zhongzhiji/xianwai-zhixin/docs/bluetooth.md

# JDY-31、CP2102 与 Tang Mega 138K Pro 接线

适用：本项目 `demo_showcase` 音游蓝牙版。新版 FPGA 默认 9600，适配从未配置的 JDY-31；旧屏幕完善版/联调增强版位流是 115200。模块、FPGA 接收器必须匹配。FPGA 无线入口仍为单向接收，实际连通需要板上验证。

## 没有 CP2102 的直接方案

不需要先改 JDY-31 参数：使用本版 9600 固件，JDY-31 TXD 接 J22.12，GND 共地，VCC 依具体底板额定电压接线。Windows 蓝牙配对成功后选择出站 SPP COM 口，打开网页“连接所选串口”；电脑无需 CP2102。Windows 若没有蓝牙适配器，可用 Android 经典蓝牙 SPP 串口应用直接发送协议字节。普通手机 H5 不能直接控制 JDY-31 SPP。旧 115200 固件不能直接接常见出厂 9600 模块。

下面“CP2102 配置”仅为以后找回转换器、希望改用旧 115200 固件时的可选方案，本次不用执行。

## 先认清三个部件

- JDY-31：Bluetooth 3.0 SPP 从机，把无线收到的数据送到 UART TXD。传输音符和曲谱事件，不是蓝牙音箱或音频解码器。
- CP2102：电脑 USB 转 UART，先用来配置 JDY-31，也可替代蓝牙直接向 FPGA 下发。它本身没有蓝牙无线功能。
- 138K：已有 `bt_rx=M26`，在底板 PMOD0/J22 的第 12 脚。新版 UART 为 9600、8 数据位、无校验、1 停止位，无硬件流控。

本地依据：`demo_showcase/constraints/music_pro.cst` 第 43–46 行，`demo_showcase/rtl/top_music_pro.v` 的 `BT_BAUD=9600` 与 `BT_CLK_PER_BIT=(35000000+BT_BAUD/2)/BT_BAUD`（3646）。接收器运行在 35 MHz 像素时钟域，不能误用模块默认的 50 MHz 参数 434。

## 供电必须按实物版本确认

京东短链分别解析到 JDY-31 商品 10223078233570 和 CP2102 商品 10150843291525，但没有取得能确认所选四针板供电及六合一跳帽含义的电气资料。因此此处不按“四针”猜供电。

JDY-31 手册区分两种版本：裸贴片模块 1.8–3.6 V，推荐 3.3 V；带稳压底板款 3.6–6 V，推荐 5 V。[JDY-31 原模块手册，参数页](https://myosuploads3.banggood.com/products/20190517/20190517042108JDY31V1.3.pdf)

供电电压和 TXD/RXD 的逻辑电平是两个概念。即使 VCC 接 5 V，送入 FPGA 的 UART 信号仍须是 3.3 V 逻辑。六合一 CP2102 必须使用 TTL/UART 接口，不使用 RS232 或 RS485 接口；不要仅凭供电跳帽就认定 TXD 电平已切换。

先对照模块背面 VCC 标注与卖家对应型号说明。若标注不清，补拍 JDY-31 正反面、CP2102 跳帽与排针区，再确定供电线。连接信号前可用万用表核对空闲 TXD 对 GND 约为 3.3 V。所有改线在断电时进行。

## 可选步骤 CP2102 配置为旧版 115200

此时 JDY-31 不接 FPGA，也不连接手机蓝牙。

| CP2102 | JDY-31 |
|---|---|
| TXD，确认 3.3 V TTL | RXD |
| RXD | TXD |
| GND | GND |
| 与模块额定输入匹配的供电输出 | VCC |

电脑插入 CP2102，串口助手选对应 COM。常见出厂设置为 9600、8N1、无流控。使用文本/ASCII 发送，每条命令末尾追加真正的 CR+LF（0D 0A），不是输入四个可见字符 `\r\n`。手册有不同固件版本，以实际回包为准。

1. 发 `AT+VERSION`，记录返回版本；再发 `AT+BAUD` 查询当前速度。
2. 固件支持时发 `AT+ENLOG0` 关闭启动/连接状态文本，避免这些文本混入业务串口。
3. 可选发 `AT+NAMEXianWaiZhiXin`，设置便于拍摄识别的名称。
4. 发 `AT+BAUD8`，对应 115200。收到应答后重启模块，把串口助手改为 115200，再查询 `AT+VERSION`、`AT+BAUD` 确认。部分版本改变波特率的生效时点不同，不以一次无回包判定损坏。

若 9600 无回包，先查供电、TX/RX、COM、换行和蓝牙是否已经连接；再检查是否此前已设成 115200。不要套用 HC-05 的 KEY 按键、38400 波特率或 `AT+UART=` 命令。

[JDY-31 原模块手册：CRLF、BAUD8=115200、ENLOG](https://www.es.co.th/Schemetic/PDF/JDY-31-K1234.PDF)。常见配对 PIN 为 1234，已改过的模块以实际设置为准。

## 第二步：JDY-31 接 138K

使用新版 9600 固件可直接进入这一步，无需 CP2102。若此前用转换器配置过模块，先拆下其 TXD/RXD。

| JDY-31 引脚 | 138K 连接 |
|---|---|
| TXD | PMOD0 / J22 第 12 脚，即 FPGA M26 / `bt_rx` |
| GND | J22 第 3 或第 4 脚，GND |
| VCC | 按模块额定电压选择，见下方 |
| RXD | 本版暂不接；FPGA 尚无 `bt_tx` 回传输出 |

对照已核对的 4071f 底板原理图：J22 第 1、2 脚是 3.3 V，第 3、4 脚是 GND，第 12 脚是 M26。需要 5 V 的底板款不能把 J22 的 3.3 V 当成 5 V；原理图 J23 第 11 脚为 +5 V，但只有确认你们实物底板版本、排针编号和供电需求后才使用该供电点。也可使用匹配的独立模块电源，并与 FPGA 共地。

请按 PCB 的 1 脚标识和原理图数脚，不按网上通用 PMOD 图片猜左右方向。这里的 M26 是 FPGA 封装脚号，并非板上第 26 个排针。不可把模块四针整排插进 J22。

[Sipeed 官方 4071f 底板原理图，第 16 页 EX CONN](https://dl.sipeed.com/fileList/TANG/Mega_138K_Pro/02_Schematic/TANG_MEGA-138K_Pro-Dock-4071f_Schematics.pdf)

## 第三步：先验证音符，再导入曲谱

烧录已有 `music_pro_showcase.fs`，用 S2 跳到屏幕标注的第 26 段 PHONE UART，按 S1 停留。这样后续自动段落不会覆盖手机操作。

安卓手机先配对 JDY-31，再在支持经典蓝牙 SPP 的串口工具里打开连接。配对成功不等于已经打开串口会话。发送方式必须是 HEX/十六进制原始字节，下面内容不要作为 ASCII 字符串发送，也不要追加换行：

```text
90 3C 64
```

这是 C4 的 Note On，力度 100。短暂试听后发送：

```text
80 3C 00
```

这是 C4 的 Note Off。手机 MIDI 接口当前采用最后音符优先，不把多指操作描述为独立多指复音。断开连接前先发送 Note Off；发生持续发声可复位 FPGA，现有协议没有无线断连确认。

三音曲谱测试：C4、D4、E4，每音一拍，120 BPM。一次连续 HEX 发送以下 21 字节：

```text
55 4C 03 78
55 57 00 3C 04
55 57 01 3E 04
55 57 02 40 04
55 43
```

以 FPGA 屏幕和音频变化确认接收。当前 FPGA 没有 ACK 回传，不会给串口工具返回“成功”。手机显示“发送成功”只说明发送动作完成。

JDY-31 是经典 SPP，不是 BLE MIDI。常见 iPhone 应用不能按本方案直接连接 JDY-31；安卓最方便。[模块供应商支持范围说明](https://docs.sunfounder.com/projects/ultimate-sensor-kit/en/latest/components_basic/38-component_jdy31.html)

现有 H5 手机页面通过电脑网关工作，不能直接访问 JDY-31 的经典 SPP。若 Windows 已成功配对模块并建立可用的 SPP 出站 COM，可将这个 COM 交给现有网关，形成“手机 Wi-Fi → 电脑 → 蓝牙 → JDY-31 → FPGA”链路；需实际验证 Windows 与该模块固件的兼容性。

## 先用 CP2102 做有线基线

这是排除无线故障最快的一步：完全移开 JDY-31 的 TXD，CP2102 TXD 接 J22.12，GND 接 J22.3/4。FPGA 按原方式供电，不接 CP2102 的 5 V/3.3 V 输出到开发板电源。CP2102 RXD 暂不接。

电脑按位流版本设 9600（本版）或 115200（旧版）、8N1、无流控，发送同样的 HEX 音符和曲谱；也可启动已有手机网关，填 CP2102 的 COM 口。先确认有线成功，再换 JDY-31。严禁两块模块的 TXD 同时接 M26。

CP2102 的芯片 UART 和供电定义可查 [Silicon Labs 数据手册](https://www.silabs.com/documents/public/data-sheets/CP2102-9.pdf)，但六合一成品板上跳帽与电平转换仍以该产品电路为准。

## 与压力采集链路的区别

本说明的 M26 是手机音符/曲谱入口。原压力采集入口是 `pressure_rx=C24`，对应 J24 第 11 脚，115200、8N1，解析原来的 16 路压力数据帧；任意串口文本或 MIDI 数据不能代替它。

一个 JDY-31 不会采集压力，也不能因为两端都叫蓝牙模块就自动连接。该型号为从机；若想把原压力采集板无线接到 FPGA，还需确认采集板上的蓝牙角色、数据帧和发送逻辑。两个从机不能直接组成主从透传链路。

本次为接线方案核对，尚未远程操作任何串口、修改模块配置或烧录 FPGA。原提交压缩包保持不变。
