zhongzhiji/xianwai-zhixin/fpga/assets/sd/README.md

# SD 曲谱

当前仓库保留曲谱 JSON 源数据。用于 FAT32 卡的 SONG.BIN 及生成记录见本地完整提交包的 12_SD卡曲谱。此目录不声称包含未提供的 BIN 文件。当前演示按键与舞台顺序请以仓库主 README 和 showcase_stages.json 为准。
