zhongzhiji/xianwai-zhixin/THIRD_PARTY_NOTICES.md

# 第三方与原始声明

- pyserial 3.5：BSD 许可证，原文保留于 fpga/phone_app/vendor/LICENSE_pyserial.txt 和相关元数据；官网 https://github.com/pyserial/pyserial 。
- Gowin 工具生成的 PLL/器件相关代码保留文件内原有声明；器件仿真原语由用户本机工具提供，不附商业工具或许可证。
- 曲谱数据与演示片段沿用项目已有材料，其原始出处/注释保留；本仓库没有为这些内容另行授予第三方音乐版权。
- 项目其余文件按原权利人权利处理，公开可读不表示新增整体开源许可。
