zhongzhiji/xianwai-zhixin/fpga/phone_app/联调增强版说明.md

# 前一版联调说明

本文件原属 115200 联调版本。当前使用方法、9600 源码和测试范围见 [README.md](README.md)。当前源码对应的新位流尚待布局布线完成。
