zhongzhiji/xianwai-zhixin/verification/README.md

# 原始验证记录

2026-11-03 本机实跑记录。路径中的个人工作目录替换为 [workspace]，结果未修改。RTL 31 项含 SD 每簇 8 扇区附加运行；网关 19 项、音游算法 7 项、浏览器 9 项。物理硬件未由这些自动化操作或验证。
