zhongzhiji/xianwai-zhixin/fpga/rtl/top_music_pro.v

`timescale 1ns/1ps
// ============================================================================
//  top_music_pro.v  ——  Tang Mega 138K Pro (GW5AST-LV138FPG676AC1/I0)
//                       音乐工作站 · 完整单工程顶层
//
//  在原 16 复音工程（top_score_fsr16_ui）基础上整合五项拓展：
//    E1  32 复音独立声部引擎        audio/src/fsr32_engine.v
//    E2  硬件效果器机架（旁/回/合/混）audio/src/fx_rack.v
//    B1  蓝牙串口链路（MIDI 子集）    rtl/bt_uart_link.v
//    B2  曲谱在线导入（走蓝牙/USB）   rtl/score_loader_uart.v
//    B3  音游节奏判定 shot 分        rtl/rhythm_judge.v
//
//  设计原则：
//   1. 原压力板链路（fsr16_uart_engine）完整保留 —— 它同时是压力解析与 UI 数据源，
//      也是 ENGINE_PRO=0 时的回退音频链路，便于现场 A/B 对比。
//   2. 全工程只有一对 clk_gen + i2s_tx（本顶层实例化），所有音频链路共用同一帧使能，
//      避免两个 I2S 发射器抢同一组 HP 引脚。
//   3. 音频选择在 48kHz 域做，不在 I2S 位时钟域做，杜绝切换毛刺。
//
//  接口备注：
//    bt_rx  M26  —— 蓝牙模块 TXD（默认 9600 8N1），必须是 3.3V 电平！
//                   上电前用万用表确认 TXD 空载电压 <= 3.3V，否则加装电平转换。
//    pressure_rx C24 —— 原有压力板 UART，不动。
// ============================================================================
module top_music_pro #(
    parameter DEBOUNCE_CYCLES            = 350000,
    parameter HOLD_CYCLES                = 21000000,
    parameter integer BT_BAUD            = 9600, // 新 JDY-31 出厂值；旧模块可设 115200
    parameter DISPLAY_PRESSURE_SHIFT     = 0,
    parameter DISPLAY_PRESSURE_FULL_SCALE= 2048,

    // ============ 常用开关：只改这几行就能换配置，不必动其它文件 ============
    parameter ENGINE_PRO   = 1,           // 1=32复音+效果器（推荐） 0=原16复音链路
    parameter [1:0] FX_MODE = 2'b00,      // 00旁路 01回声 10合唱 11混响
    parameter [3:0] VIB_DEPTH = 4'd0,     // 颤音深度，0=关；建议 8~15
    parameter       GLIDE_EN  = 0,        // 滑音开关（需上层给出 glide_rate）
    parameter       TEST_MODE = 0,        // 1=上电默认打开 N 音测试（三键长按可现场循环）
    parameter [5:0] TEST_COUNT = 6'd32,   // 上电默认测试声部数；运行时档位固定为 4/8/16/32
    // 预录 VOCAL.WAV 不属于赛题的 HDL 实时合成主链，默认不例化。
    // 代码与工具保留供附加演示；ENABLE_VOCAL=1 时需重新评估 BSRAM 与布线。
    parameter       ENABLE_VOCAL = 0,

    parameter ROM_FILE      = "audio/rom/wavetable_showcase.mem",
    parameter SINE_ROM_FILE = "audio/rom/sine_lfo_256.mem",
    parameter MIDI_FW_ROM   = "audio/rom/midi_fw.mem",
    // 弯音轮（Pitch Bend）倍率表：128 项 × 16 bit，Q15 定点（0x8000 = 1.0 倍）
    //   BEND_EN=0 → 旁路（fw 原样通过，省一个乘法器）
    //   表由 tools/gen_bend_lut.py 生成，默认 ±2 半音（MIDI 规范默认音域）
    parameter       BEND_EN  = 1,
    parameter BEND_LUT_FILE  = "audio/rom/bend_lut.mem"
)(
    input  wire       sys_clk,            // P16  50 MHz
    input  wire       rst_n,              // K16
    input  wire       key_play_n,         // F15
    input  wire       key_timbre_n,       // G15
    input  wire       key_demo_n,         // G16

    input  wire       pressure_rx,        // C24  压力板 UART
    input  wire       bt_rx,              // M26  蓝牙模块 TXD

    // 钢琴键盘 —— 方案 A：MIDI 1.0（5 针 DIN 经 6N138 光耦，只占 1 根 IO）
    input  wire       midi_rx,            // P23  40P 排针 J23 物理 9 脚

    // 钢琴键盘 —— 方案 B：8×8 行列矩阵直连电子琴键盘总成（可选，占 16 根 IO）
    //   不用矩阵时这些脚全部悬空即可：列有上拉，行推挽输出不影响其它功能。
    output wire [7:0] kb_row,             // 行驱动（推挽，同一时刻只拉低一根）
    input  wire [7:0] kb_col,             // 列采样（内部上拉，按下被拉低）

    // 触摸载板 TouchCarrier R11（双 MPR121，见 docs/01_触摸载板接线与使用指南.md）
    inout  wire       touch_scl,          // H14  J24.5
    inout  wire       touch_sda,          // H15  J24.6
    input  wire       touch_irq_n,        // L17  J24.7（两颗 IRQ 开漏线或）

    // SD 卡（SPI）—— PMOD2 / J26 的 9..12 脚
    output wire       sd_sclk,            // D23  底板板载 microSD 卡槽
    output wire       sd_mosi,            // D24
    input  wire       sd_miso,            // H23
    output wire       sd_csn,             // B25

    output wire       lcd_clk,
    output wire       lcd_de,
    output wire [5:0] lcd_r, lcd_g, lcd_b,

    output wire [1:0] led_n,
    output wire       hp_bck, hp_ws, hp_din, pa_en
);

    // ------------------------------------------------------------------
    // 1. 时钟与复位
    // ------------------------------------------------------------------
    wire pixel_clk, locked, pixel_reset_n, system_reset_n;
    lcd_pll u_pll(.clkin(sys_clk), .clkout0(pixel_clk), .locked(locked));
    reset_sync u_pixel_reset (.clk(pixel_clk), .reset_button_n(rst_n & locked),
                              .reset_n(pixel_reset_n));
    reset_sync u_system_reset(.clk(sys_clk),  .reset_button_n(rst_n & locked),
                              .reset_n(system_reset_n));

    // ------------------------------------------------------------------
    // 2. 48 kHz 音频时基：全工程唯一一对 clk_gen / i2s_tx
    // ------------------------------------------------------------------
    wire bck, bck_rise, bck_fall, frame_en;
    clk_gen #(.ACC_MOD(50000), .ACC_STEP(3072)) u_ckg(
        .clk(sys_clk), .rst_n(system_reset_n),
        .bck(bck), .bck_rise(bck_rise), .bck_fall(bck_fall));

    // ------------------------------------------------------------------
    // 3. 按键与 UI 控制
    // ------------------------------------------------------------------

    // Offline test stimuli. No pressure/BT device is reported online by these signals.
    wire [4:0] show_stage; wire show_hold;
    wire [15:0] show_gate; wire [6:0] show_expr;
    wire [1:0] show_family,show_preset,show_fx;
    wire [2:0] show_page,show_test;
    wire [3:0] show_vib; wire show_glide,show_melody,show_backing;
    wire [31:0] show_word;
    wire show_pause_press,show_next_press,show_restart_press;
    ui_action_button #(.DEBOUNCE_CYCLES(500000),.HOLD_CYCLES(30000000)) u_show_s1(
        .clk(sys_clk),.reset_n(system_reset_n),.button_n(key_play_n),
        .short_press(show_pause_press),.long_press(),.pressed());
    ui_action_button #(.DEBOUNCE_CYCLES(500000),.HOLD_CYCLES(30000000)) u_show_s2(
        .clk(sys_clk),.reset_n(system_reset_n),.button_n(key_timbre_n),
        .short_press(show_next_press),.long_press(show_restart_press),.pressed());
    showcase_director u_show(.clk(sys_clk),.reset_n(system_reset_n),
        .pause_press(show_pause_press),.next_press(show_next_press),.restart_press(show_restart_press),
        .stage(show_stage),.held(show_hold),.gate(show_gate),.expression(show_expr),
        .family(show_family),.preset(show_preset),.fx(show_fx),.page(show_page),
        .test_sel(show_test),.vib_depth(show_vib),.glide(show_glide),
        .melody(show_melody),.backing(show_backing),.freq_word(show_word));
    wire [21:0] show_config_pixel;
    bus_snapshot_cdc #(.WIDTH(22)) u_show_mailbox(
        .src_clk(sys_clk),.src_reset_n(system_reset_n),
        .src_data({show_hold,show_stage,show_page,show_family,show_preset,show_fx,show_test,show_backing,3'b000}),
        .dst_clk(pixel_clk),.dst_reset_n(pixel_reset_n),.dst_data(show_config_pixel));
    wire [4:0] show_stage_p=show_config_pixel[20:16];
    wire show_serial,show_serial_busy,show_serial_done;
    reg [4:0] show_stage_prev;
    always @(posedge pixel_clk or negedge pixel_reset_n)
        if(!pixel_reset_n) show_stage_prev<=31; else show_stage_prev<=show_stage_p;
    showcase_uart_rom #(.CLK_PER_BIT((35000000+BT_BAUD/2)/BT_BAUD)) u_show_serial(
        .clk(pixel_clk),.reset_n(pixel_reset_n),
        .start(show_stage_p==23 && show_stage_prev!=23),
        .tx(show_serial),.busy(show_serial_busy),.done(show_serial_done));
    wire selected_bt_rx=show_serial_busy ? show_serial : bt_rx;

    wire short_play, long_song, short_timbre, long_family, short_page, long_mode;
    wire [2:0] button_pressed, button_short, button_long, normal_short, normal_long;
    wire volume_edit;
    wire [4:0] volume_step;
    wire [1:0] practice_mode;
    wire backing_enabled;
    assign {short_page, short_timbre, short_play} = normal_short;
    assign {long_mode,  long_family,  long_song } = normal_long;

    ui_action_button #(.DEBOUNCE_CYCLES(DEBOUNCE_CYCLES), .HOLD_CYCLES(HOLD_CYCLES)) u_s1(
        .clk(pixel_clk), .reset_n(pixel_reset_n), .button_n(1'b1),
        .short_press(button_short[0]), .long_press(button_long[0]),
        .pressed(button_pressed[0]));
    ui_action_button #(.DEBOUNCE_CYCLES(DEBOUNCE_CYCLES), .HOLD_CYCLES(HOLD_CYCLES)) u_s2(
        .clk(pixel_clk), .reset_n(pixel_reset_n), .button_n(1'b1),
        .short_press(button_short[1]), .long_press(button_long[1]),
        .pressed(button_pressed[1]));
    ui_action_button #(.DEBOUNCE_CYCLES(DEBOUNCE_CYCLES), .HOLD_CYCLES(HOLD_CYCLES)) u_s3(
        .clk(pixel_clk), .reset_n(pixel_reset_n), .button_n(key_demo_n),
        .short_press(button_short[2]), .long_press(button_long[2]),
        .pressed(button_pressed[2]));
    wire fx_step, test_step;   // 三键齐按：短按换效果器 / 长按换 N 音测试
    ui_volume_control #(.HOLD_CYCLES(HOLD_CYCLES)) u_volume_controls(
        .clk(pixel_clk), .reset_n(pixel_reset_n), .pressed(button_pressed),
        .short_action(button_short), .long_action(button_long),
        .normal_short(normal_short), .normal_long(normal_long),
        .volume_edit(volume_edit), .volume_step(volume_step),
        .practice_mode(practice_mode), .backing_enabled(backing_enabled),
        .fx_step(fx_step), .test_step(test_step));

    // ------------------------------------------------------------------
    // 4. 压力显示映射
    // ------------------------------------------------------------------
    wire [7:0]  frame_count;
    wire [43:0] controls_pixel, controls_system;
    wire [15:0] live_gate;
    wire        frame_ok, online;
    wire [23:0] dev_max;
    wire [6:0]  expression;
    wire [23:0] display_deviation = dev_max >> DISPLAY_PRESSURE_SHIFT;
    // ------------------------------------------------------------------
    // 4c. 演奏力度（表情）通路的下限保护
    //
    //    【为什么必须加这一层】
    //    expression 来自 pressure_display_mapper，而那个模块的注释自己就写着
    //    "Display-only pressure normalization" —— 它是**给显示用的**归一化值：
    //      !online   → level = 0      （压力板没连）
    //      deviation==0 → level = 0  （没用力按）
    //    但 fsr32_engine 把 expression 当成主增益（gain = expression/128），
    //    直接接等于：不接压力板、或轻轻按一下，整条 32 复音链路就几乎静音。
    //    这就是"接音响声音很小"的第一个原因。
    //
    //    所以给表情通路兜底：离线用默认力度，在线但有力度时限制下限。
    //    设下限不会产生底噪 —— expression 只是增益，gate=0 时声部输出本来就是 0。
    // ------------------------------------------------------------------
    parameter [6:0] EXPR_DEFAULT = 7'd112;   // 压力板离线时的默认力度（满量程 127）
    parameter [6:0] EXPR_MIN     = 7'd56;    // 在线时的力度下限，避免轻触近乎无声

    wire [6:0] expr_eff = !online              ? EXPR_DEFAULT :
                          (expression < EXPR_MIN) ? EXPR_MIN     : expression;

    // 沿用原语义：expression 仍按真实值送去做显示
    pressure_display_mapper #(.FULL_SCALE(DISPLAY_PRESSURE_FULL_SCALE)) u_pressure_display(
        .clk(sys_clk), .reset_n(system_reset_n), .online(online),
        .deviation(display_deviation), .level(expression));

    wire enabled   = 1'b1;
    wire demo_mode = show_melody;
    wire [1:0] family = show_family;
    wire [1:0] preset = show_preset;
    wire [4:0] vol_step = controls_system[28:24];

    // ------------------------------------------------------------------
    // 4b. 触摸载板（双 MPR121）：16 琴键 + 6 琴弦 + 弯音 + 颤音
    //
    //    整块跑在 sys_clk(50MHz) 域：I2C 主机本身就是 50MHz 参数化的，
    //    而且琴键状态属于"准静态"（一次触摸至少几十毫秒），
    //    不需要事件级跨时钟握手，直接同域最干净。
    //
    //    琴键直接并进 live_gate：与压力板 16 个通道共用同一套音高映射，
    //    于是 32 复音引擎、UI 显示、音游判定三处同时生效——
    //    不需要为钢琴键盘再单独写一条显示/判定通路。
    // ------------------------------------------------------------------
    wire [15:0] touch_keys;
    wire [5:0]  touch_strings;
    wire        touch_bend, touch_vib, touch_online, touch_fault, touch_clear;

    touch_carrier #(
        .CLK_HZ(50000000), .I2C_HZ(100000), .POLL_US(2000),
        .ADDR_A(7'h5a), .ADDR_B(7'h5b)
    ) u_touch (
        .clk(sys_clk), .reset_n(system_reset_n),
        .scl(touch_scl), .sda(touch_sda), .irq_n(touch_irq_n),
        .keys(touch_keys), .key_press(), .key_release(),
        .strings(touch_strings), .string_press(),
        .bend(touch_bend), .vib(touch_vib),
        .online(touch_online), .fault(touch_fault), .fault_code(),
        .clear_event(touch_clear), .error_event(), .sample_valid());

    // 掉线是脉冲、故障是电平，这里合成一个"粘滞"故障位：
    // 瞬时掉线也能在 LED 上看到，不会因为自愈而被抹掉。
    reg touch_fault_hold;
    always @(posedge sys_clk or negedge system_reset_n) begin
        if (!system_reset_n)             touch_fault_hold <= 1'b0;
        else if (touch_clear)            touch_fault_hold <= 1'b1;
        else if (touch_online)           touch_fault_hold <= 1'b0;
    end

    // 琴弦 6 条 → 音色切换。这是"电平"不是脉冲，跨时钟用快照邮箱不会丢。
    wire [7:0] touch_state_pixel;
    bus_snapshot_cdc #(.WIDTH(8)) u_touch_mailbox(
        .src_clk(sys_clk),  .src_reset_n(system_reset_n),
        .src_data({touch_online, touch_fault_hold, touch_strings}),
        .dst_clk(pixel_clk), .dst_reset_n(pixel_reset_n),
        .dst_data(touch_state_pixel));

    wire        touch_online_p = touch_state_pixel[7];
    wire        touch_fault_p  = touch_state_pixel[6];
    wire [5:0]  touch_strings_p = touch_state_pixel[5:0];

    // 新按下一条弦 → 给显示核心一个"换乐器"脉冲（在 pixel 域生成，避免脉冲跨时钟丢失）
    reg [5:0] strings_prev;
    always @(posedge pixel_clk or negedge pixel_reset_n) begin
        if (!pixel_reset_n) strings_prev <= 6'd0;
        else                strings_prev <= touch_strings_p;
    end
    wire string_switch = (touch_strings_p != 6'd0) && (strings_prev == 6'd0);

    function integer pitch_index;
        input integer channel;
        begin
            case (channel)
                0:pitch_index=0;  1:pitch_index=2;  2:pitch_index=4;  3:pitch_index=5;
                4:pitch_index=7;  5:pitch_index=9;  6:pitch_index=11; 7:pitch_index=12;
                8:pitch_index=14; 9:pitch_index=16; 10:pitch_index=17;11:pitch_index=19;
                12:pitch_index=21;13:pitch_index=23;14:pitch_index=24;15:pitch_index=26;
                default:pitch_index=0;
            endcase
        end
    endfunction

    // 琴键与压力板共用同一套 16 音映射，任一输入源按下即发声。
    // touch_carrier 掉线时自身会把 keys 清零（fail_safe），所以这里不会卡音。
    wire [15:0] live_gate_mix = show_gate;

    wire [31:0] live_notes =
        ({31'd0,live_gate_mix[0]}  << 0)  | ({31'd0,live_gate_mix[1]}  << 2)  |
        ({31'd0,live_gate_mix[2]}  << 4)  | ({31'd0,live_gate_mix[3]}  << 5)  |
        ({31'd0,live_gate_mix[4]}  << 7)  | ({31'd0,live_gate_mix[5]}  << 9)  |
        ({31'd0,live_gate_mix[6]}  << 11) | ({31'd0,live_gate_mix[7]}  << 12) |
        ({31'd0,live_gate_mix[8]}  << 14) | ({31'd0,live_gate_mix[9]}  << 16) |
        ({31'd0,live_gate_mix[10]} << 17) | ({31'd0,live_gate_mix[11]} << 19) |
        ({31'd0,live_gate_mix[12]} << 21) | ({31'd0,live_gate_mix[13]} << 23) |
        ({31'd0,live_gate_mix[14]} << 24) | ({31'd0,live_gate_mix[15]} << 26);

    // ------------------------------------------------------------------
    // 5. 试听振荡源（沿用原工程口径）
    // ------------------------------------------------------------------
    wire auto_note_gate;
    wire [31:0] auto_freq_word;
    chromatic_audition #(.DIRECT_MIDI(1)) u_audition_pitch(
        .clk50(sys_clk), .reset_n(system_reset_n),
        .notes(controls_system[23:0]), .midi_note(controls_system[43:37]),
        .gate(auto_note_gate), .freq_word(auto_freq_word));

    reg live_armed;
    always @(posedge sys_clk or negedge system_reset_n) begin
        if (!system_reset_n)                                    live_armed <= 1'b0;
        else if (!enabled || demo_mode || !online)              live_armed <= 1'b0;
        else if (live_gate == 16'd0)                            live_armed <= 1'b1;
    end

    // ------------------------------------------------------------------
    // 6. 原 16 复音链路（压力解析 + UI 数据源 + 回退音频）
    //    其 HP_* / PA_EN 输出在本工程中不再使用，全部由本顶层统一驱动。
    // ------------------------------------------------------------------
    wire signed [15:0] pcm16;
    wire        sample_en16;
    fsr16_uart_engine #(.CHROMATIC_AUDITION(1)) u_legacy_audio(
        .clk50(sys_clk), .rst_n(system_reset_n), .uart_rx(pressure_rx),
        .enable(enabled && (demo_mode || live_armed || controls_system[29])),
        .demo_mode(demo_mode),
        .family(family), .preset(preset), .octave(2'd1),
        .volume_step(vol_step),
        .backing_enabled(controls_system[29]),
        .backing_gate(auto_note_gate), .backing_freq_word(auto_freq_word),
        .external_gate({15'd0, auto_note_gate}),
        .external_freq_override(demo_mode),
        .external_freq_word(auto_freq_word),
        .HP_BCK(), .HP_WS(), .HP_DIN(), .PA_EN(),
        .live_gate(live_gate), .values(), .frame_ok(frame_ok), .online(online),
        .dev_max(dev_max), .levels(),
        .pcm(pcm16), .sample_en(sample_en16),
        .note_on(), .note_off(), .voices_active(), .clipped());

    // ------------------------------------------------------------------
    // 7. 蓝牙链路 + 曲谱在线导入（两个接收器共用同一根 bt_rx 引脚）
    //
    //    【为什么这两个模块跑在 pixel_clk(35MHz) 域，而不是 sys_clk(50MHz)】
    //    score_loader_uart 的 load_we / load_commit 是**单拍脉冲事件**，
    //    目的地 score_display_core 正好在 pixel_clk 域。若留在 sys_clk 域，
    //    这 34 根多比特总线就是一条未同步的异步路径（实测会炸出 1151 个
    //    setup + 1577 个 hold 违例）。两级同步修不住多比特同时跳变，
    //    bus_snapshot_cdc 也明确禁止用于事件脉冲（快照会被合并）。
    //    把源头挪到目的同域，才是唯一干净的解法。
    //    分频按 35MHz 和 BT_BAUD 四舍五入；9600 -> 3646，115200 -> 304。
    // ------------------------------------------------------------------
    localparam integer BT_CLK_PER_BIT = (35000000+BT_BAUD/2)/BT_BAUD;
    localparam integer BT_IDLE_TO     = 8750000;          // 0.25s @35MHz

    wire        bt_note_on, bt_note_off;
    wire [6:0]  bt_midi_note, bt_velocity;
    wire        bt_raw_valid, bt_alive;
    wire [7:0]  bt_raw_data;
    bt_uart_link #(.CLK_PER_BIT(BT_CLK_PER_BIT), .IDLE_TIMEOUT(BT_IDLE_TO)) u_bt(
        .clk(pixel_clk), .rst_n(pixel_reset_n), .bt_rx(selected_bt_rx),
        .note_on(bt_note_on), .note_off(bt_note_off),
        .midi_note(bt_midi_note), .velocity(bt_velocity),
        .raw_data(bt_raw_data), .raw_valid(bt_raw_valid),
        .link_alive(bt_alive), .rx_count());

    wire        load_we, load_commit, frame_done, commit_accept;
    wire [7:0]  load_addr;                 // 曲谱容量 64→255，地址扩到 8 位
    wire [6:0]  load_note;
    wire [7:0]  load_count;
    wire [3:0]  load_length;
    wire [7:0]  load_bpm, ld_err_count;
    wire [2:0]  ld_err_code;
    // 【顺序要求】必须先声明再使用：Gowin 的 Verilog-2001 解析器遇到
    // 「先使用后声明」不会报错中断，而是建一个 1bit 隐式 wire，导致
    // load_addr/load_note/load_length 全被截成 1 位——蓝牙导入曲谱会静默失效。
    wire        bt_ld_we, bt_ld_commit;
    wire [7:0]  bt_ld_addr;
    wire [6:0]  bt_ld_note;
    wire [7:0]  bt_ld_count;
    wire [3:0]  bt_ld_length;
    wire [7:0]  bt_ld_bpm;
    score_loader_uart #(.CLK_PER_BIT(BT_CLK_PER_BIT)) u_score_loader(
        .clk(pixel_clk), .rst_n(pixel_reset_n), .rx(selected_bt_rx),
        .load_we(bt_ld_we), .load_addr(bt_ld_addr),
        .load_note(bt_ld_note), .load_length(bt_ld_length),
        .load_commit(bt_ld_commit), .load_count(bt_ld_count), .load_bpm(bt_ld_bpm),
        .frame_done(frame_done), .commit_accept(commit_accept),
        .err_code(ld_err_code), .err_count(ld_err_count), .recv_count());

    // ------------------------------------------------------------------
    // 7b. SD 卡曲谱导入
    //
    //    为什么也跑在 pixel_clk 域：与蓝牙通道完全同理 —— load_we/load_commit
    //    是单拍事件脉冲，目的地 score_display_core 在 pixel_clk 域。
    //    SPI 分频按 35MHz 算（280→125kHz 初始化，8→4.375MHz 数据）。
    //
    //    两条通道共用 score_loader_core，所以 SD 卡里放的就是同样的 0x55 帧
    //    字节流（tools/send_score.py 生成的 .bin），不需要第二种文件格式。
    // ------------------------------------------------------------------
    wire        sd_loading, sd_found, sd_done;
    wire [2:0]  sd_fat_err;
    wire        sd_card_ready;
    wire [3:0]  sd_card_err;
    wire        sd_ld_we, sd_ld_commit;
    wire [7:0]  sd_ld_addr;
    wire [6:0]  sd_ld_note;
    wire [7:0]  sd_ld_count;
    wire [3:0]  sd_ld_length;
    wire [7:0]  sd_ld_bpm;

    // 卡一就绪就自动装载一次（上电即换曲，不需要按键）
    reg prev_sd_ready, sd_started;
    always @(posedge pixel_clk or negedge pixel_reset_n) begin
        if (!pixel_reset_n) begin prev_sd_ready <= 1'b0; sd_started <= 1'b0; end
        else begin
            prev_sd_ready <= sd_card_ready;
            if (sd_card_ready && !prev_sd_ready) sd_started <= 1'b1;
            else                                 sd_started <= 1'b0;
        end
    end

    // SPI 总线是**共享**的：曲谱装载器与 WAV 播放器各带一个 sd_card_ctrl，
    // 同一时刻只能有一个驱动引脚，否则两边一起拽 CS/SCK 会把卡搞死。
    // 仲裁规则很简单：装载期间归装载器，装载结束（或出错）后永久交给播放器。
    wire sc_sclk, sc_mosi, sc_csn;
    wire wv_sclk, wv_mosi, wv_csn;
    reg  bus_to_wav;
    always @(posedge pixel_clk or negedge pixel_reset_n) begin
        if (!pixel_reset_n)                       bus_to_wav <= 1'b0;
        else if (ENABLE_VOCAL==0)                 bus_to_wav <= 1'b0;
        else if (sd_loading)                      bus_to_wav <= 1'b0;
        else if (sd_done || (sd_fat_err != 3'd0)) bus_to_wav <= 1'b1;
    end
    assign sd_sclk = (ENABLE_VOCAL!=0 && bus_to_wav) ? wv_sclk : sc_sclk;
    assign sd_mosi = (ENABLE_VOCAL!=0 && bus_to_wav) ? wv_mosi : sc_mosi;
    assign sd_csn  = (ENABLE_VOCAL!=0 && bus_to_wav) ? wv_csn  : sc_csn;

    sd_score_loader #(
        .SPI_DIV_INIT(280), .SPI_DIV_FAST(8), .DIR_SEC_CAP(8)
    ) u_sd_score (
        .clk(pixel_clk), .rst_n(pixel_reset_n), .start(sd_started),
        .sd_sclk(sc_sclk), .sd_mosi(sc_mosi), .sd_miso(sd_miso), .sd_csn(sc_csn),
        .card_ready(sd_card_ready), .card_err(sd_card_err),
        .loading(sd_loading), .file_found(sd_found), .load_done(sd_done),
        .fat_err(sd_fat_err),
        .load_we(sd_ld_we), .load_addr(sd_ld_addr), .load_note(sd_ld_note),
        .load_length(sd_ld_length), .load_commit(sd_ld_commit),
        .load_count(sd_ld_count), .load_bpm(sd_ld_bpm),
        .frame_done(), .commit_accept(), .err_code(), .err_count(), .recv_count());

    // 两条装载通道互斥：SD 装载期间屏蔽蓝牙通道，防止两边同时驱动 load_*
    assign load_we     = (sd_loading && show_stage_p<23) ? sd_ld_we     : bt_ld_we;
    assign load_addr   = (sd_loading && show_stage_p<23) ? sd_ld_addr   : bt_ld_addr;
    assign load_note   = (sd_loading && show_stage_p<23) ? sd_ld_note   : bt_ld_note;
    assign load_length = (sd_loading && show_stage_p<23) ? sd_ld_length : bt_ld_length;
    assign load_commit = (sd_loading && show_stage_p<23) ? sd_ld_commit : bt_ld_commit;
    assign load_count  = (sd_loading && show_stage_p<23) ? sd_ld_count  : bt_ld_count;
    assign load_bpm    = (sd_loading && show_stage_p<23) ? sd_ld_bpm    : bt_ld_bpm;

    // ------------------------------------------------------------------
    // 8. 蓝牙 MIDI → 32 复音外部合奏声部（voice 16..31）
    //    ext_gate 是 16 个音程开关；根音共用同一个 ext_freq_word。
    //    【重要】ensemble 的最高声部是根音 <<2，根音超过 MIDI84(C6) 会溢出绕回，
    //            故在此做安全钳位到 C6。
    //
    //    蓝牙按键状态要送进 sys_clk 域的 fsr32_engine。这里传的是
    //    "当前按住哪个音"的**准静态状态**，不是脉冲事件——按键最短也有几十毫秒，
    //    远长于握手往返的 ~4 拍，因此不会丢音，也不违背 mailbox 的使用限制。
    // ------------------------------------------------------------------
    reg        bt_active_r;
    reg [6:0]  bt_note_r, bt_vel_r;
    always @(posedge pixel_clk or negedge pixel_reset_n) begin
        if (!pixel_reset_n) begin
            bt_active_r <= 1'b0; bt_note_r <= 7'd0; bt_vel_r <= 7'd0;
        end else begin
            if (bt_note_on) begin
                bt_active_r <= 1'b1; bt_note_r <= bt_midi_note; bt_vel_r <= bt_velocity;
            end else if (bt_note_off && (bt_midi_note == bt_note_r)) begin
                bt_active_r <= 1'b0;      // 松开的是当前音才松，避免错杀后按下的音
            end
        end
    end
    wire [14:0] bt_state_sys;
    bus_snapshot_cdc #(.WIDTH(15)) u_bt_mailbox(
        .src_clk(pixel_clk), .src_reset_n(pixel_reset_n),
        .src_data({bt_active_r, bt_note_r, bt_vel_r}),
        .dst_clk(sys_clk),  .dst_reset_n(system_reset_n), .dst_data(bt_state_sys));

    wire        bt_active_s = bt_state_sys[14];
    wire [6:0]  bt_note_s   = bt_state_sys[13:7];
    wire [6:0]  bt_vel_s    = bt_state_sys[6:0];

    reg [31:0] midi_fw_rom [0:127];
    initial $readmemh(MIDI_FW_ROM, midi_fw_rom);

    wire [6:0]   bt_root    = (bt_note_s > 7'd84) ? 7'd84 : bt_note_s;
    wire [31:0]  bt_root_fw = midi_fw_rom[bt_root];

    // ------------------------------------------------------------------
    // 8b. 钢琴键盘接入（方案 A：MIDI 1.0；方案 B：8×8 行列矩阵）
    //
    //   两条通道最终都归到同一张 128 位「当前按住的音符表」：
    //     - MIDI：note_on 置位、note_off 清零（velocity==0 已在 midi_uart_rx 里
    //       归一成 note_off，符合 MIDI 规范）；延音踏板踩下时暂缓清零。
    //     - 矩阵：64 个键映射到 C2(36) .. B6(95)，即 note_state[99:36]。
    //   然后 chord_from_keys 把这张表压成「根音 + 16 位音程掩码」，正好对齐
    //   fsr32_engine 的 ext_gate / ext_freq_word 接口 —— 弹和弦就是同时点亮
    //   多个音程，与蓝牙链路的用法完全一致，不需要改动引擎。
    //
    //   优先级：键盘/MIDI 有键按下时覆盖蓝牙（现场谁在弹谁优先）。
    // ------------------------------------------------------------------
    //   延音踏板（CC64）与调制轮（CC1→颤音）见下方 midi_held / vib_from_mod。
    wire        midi_on, midi_off;
    wire [6:0]  midi_on_num, midi_on_vel, midi_off_num;
    wire        midi_sustain;
    wire [6:0]  midi_mod;
    wire [7:0]  midi_msgs, midi_errs;
    wire        midi_act;
    wire signed [13:0] midi_bend;          // -8192 .. +8191

    midi_uart_rx #(
        .CLK_HZ(50000000), .BAUD(31250), .OVER(8)
    ) u_midi_rx(
        .clk(sys_clk), .rst_n(system_reset_n), .midi_rx(midi_rx),
        .note_on(midi_on),      .note_on_num(midi_on_num),  .note_on_vel(midi_on_vel),
        .note_off(midi_off),    .note_off_num(midi_off_num),
        .sustain(midi_sustain), .mod_wheel(midi_mod),
        .channel_volume(),      .pitch_bend(midi_bend),
        .msg_count(midi_msgs),  .err_count(midi_errs), .activity(midi_act));

    // 延音踏板：踩下时松键不立即消音，踏板抬起才统一放掉
    reg         sustain_d;
    reg [127:0] midi_held, midi_sust;
    always @(posedge sys_clk or negedge system_reset_n) begin
        if (!system_reset_n) begin
            midi_held <= 128'd0; midi_sust <= 128'd0; sustain_d <= 1'b0;
        end else begin
            sustain_d <= midi_sustain;
            if (midi_on) begin
                midi_held[midi_on_num] <= 1'b1;
                midi_sust[midi_on_num] <= 1'b0;
            end
            if (midi_off) begin
                midi_held[midi_off_num] <= 1'b0;
                if (midi_sustain) midi_sust[midi_off_num] <= 1'b1;
            end
            if (sustain_d && !midi_sustain) midi_sust <= 128'd0;   // 抬踏板
        end
    end

    // 8×8 键盘矩阵（不接键盘时全部悬空，不影响其它功能）
    wire [63:0] kb_state;
    wire        kb_change, kb_valid, kb_ghost;
    wire [5:0]  kb_index;

    key_matrix_scan #(
        .ROWS(8), .COLS(8), .KEYW(6),
        .CLK_HZ(50000000), .ROW_US(100), .FRAMES(3), .ACTIVE_LOW(1)
    ) u_key_matrix(
        .clk(sys_clk), .rst_n(system_reset_n),
        .row_drv(kb_row), .col_in(kb_col),
        .key_state(kb_state), .key_change(kb_change),
        .key_valid(kb_valid), .key_index(kb_index),
        .ghost_warn(kb_ghost));

    // 矩阵键 → MIDI 编号：键 0 起算 C2(36)，64 键覆盖 C2..B6（36..99）
    wire [127:0] kb_note_map = {28'd0, kb_state, 36'd0};

    wire [127:0] note_state = midi_held | midi_sust | kb_note_map;

    wire [6:0]  chord_root;
    wire [15:0] chord_mask;
    wire        chord_active;
    chord_from_keys #(.KEYS(128), .IDXW(7)) u_chord(
        .clk(sys_clk), .rst_n(system_reset_n), .key_state(note_state),
        .root_note(chord_root), .interval_mask(chord_mask), .active(chord_active));

    wire [6:0]  chord_root_c  = (chord_root > 7'd84) ? 7'd84 : chord_root;
    wire [31:0] chord_root_fw = midi_fw_rom[chord_root_c];

    // ★ 频率字 ROM 读出的结果再打一拍再交给引擎。
    //   midi_fw_rom 是 128×32 的块 RAM，读出来还要经过「键盘/蓝牙二选一」、
    //   声部选择、颤音乘法的 B 端口，整条组合链实测 20.79ns —— 超过 20ns 周期，
    //   一个 bt_mailbox 就炸出 8 个 setup 违例端点。打一拍把链切断，
    //   代价 20ns 延迟，对按键/踏板完全无感。
    reg         chord_active_d;
    reg [15:0]  chord_mask_d;
    reg [31:0]  chord_root_fw_d, bt_root_fw_d;
    always @(posedge sys_clk or negedge system_reset_n) begin
        if (!system_reset_n) begin
            chord_active_d  <= 1'b0;
            chord_mask_d    <= 16'd0;
            chord_root_fw_d <= 32'd0;
            bt_root_fw_d    <= 32'd0;
        end else begin
            chord_active_d  <= chord_active;
            chord_mask_d    <= chord_mask;
            chord_root_fw_d <= chord_root_fw;
            bt_root_fw_d    <= bt_root_fw;
        end
    end

    // ------------------------------------------------------------------
    // 8c. 弯音轮（Pitch Bend）→ 根音频率微调
    //
    //   midi_uart_rx 解出的 pitch_bend 是 14 位补码（-8192..+8191）。取高 7 位
    //   当索引查 128 项 Q15 倍率表（0x8000 = 1.0 倍），再与根音频率字相乘。
    //   两级流水（查表一拍、乘法一拍），乘法落在两个寄存器之间 —— 这是吸取
    //   fsr_gate / chord_from_keys 的教训，绝不让乘法出现在纯组合链里。
    //
    //   只作用于键盘/MIDI 通路：蓝牙曲谱和 SD 卡曲谱是固定音高，不该被弯音带跑。
    //   矩阵键盘不会发弯音消息，bend 恒为 0 → 倍率恒 1.0，行为与接之前完全一致。
    //
    //   表与实现：tools/gen_bend_lut.py 生成（默认 ±2 半音，每档 3.1 音分），
    //   rtl/pitch_bend_apply.v 实现，sim/tb_pitch_bend.v 验证。
    // ------------------------------------------------------------------
    wire [31:0] chord_fw_bent_r;
    pitch_bend_apply #(
        .BEND_EN(BEND_EN), .LUT_FILE(BEND_LUT_FILE)
    ) u_bend(
        .clk(sys_clk), .rst_n(system_reset_n),
        .bend(midi_bend), .fw_in(chord_root_fw_d), .fw_out(chord_fw_bent_r));

    // 调制轮（CC1）推颤音：有键时才生效，避免空闲时白抖动
    wire [3:0]  vib_from_mod = (chord_active && midi_mod > 7'd8) ? midi_mod[6:3] : 4'd0;

    // 力度越大，点亮的音程越多（钢琴式的强弱表情）
    function [15:0] vel_to_extgate;
        input [6:0] vel;
        begin
            if      (vel < 7'd32) vel_to_extgate = 16'h0002;   // 同度
            else if (vel < 7'd64) vel_to_extgate = 16'h000E;   // +三度 +五度
            else if (vel < 7'd96) vel_to_extgate = 16'h007E;   // +八度 +十度 +十二度
            else                  vel_to_extgate = 16'h03FE;   // 满编
        end
    endfunction

    // 键盘/MIDI 优先；没有键按下时才回落到蓝牙力度和弦
    wire [15:0] ext_gate_r = chord_active_d ? chord_mask_d
                           : (bt_active_s ? vel_to_extgate(bt_vel_s) : 16'd0);
    // 注意：走的是弯音后的频率字（chord_fw_bent_r），见 8c 节
    wire [31:0] ext_word_r = chord_active_d ? chord_fw_bent_r : bt_root_fw_d;

    // ------------------------------------------------------------------
    // 9. 32 复音 Pro 引擎 + 效果器机架
    // ------------------------------------------------------------------
    wire signed [15:0] pcm32, pcm_fx;
    wire               fx_active;
    wire [31:0] v32_active;

    wire [3:0] vib_base     = (vib_from_mod > VIB_DEPTH[3:0]) ? vib_from_mod : VIB_DEPTH[3:0];
    // 颤音：触摸 VIB 电极或 MIDI 调制轮都可强制开启（参数 VIB_DEPTH 仍可给出常开基线）
    wire [3:0] vib_depth_eff = touch_vib ? 4'd10 : vib_base;
    // 弯音：触摸 BEND 电极时强制开启滑音（fsr32_engine 的 glide_en 是端口，可直接改）
    wire       glide_en_eff  = (GLIDE_EN != 0) | touch_bend;

    // ------------------------------------------------------------------
    // 8c. 效果器 / N 音测试的**运行时**切换（赛题"评分规则3 现场验证"）
    //     三键齐按（S1+S2+S3）：短按循环 旁路→回声→合唱→混响；
    //                           长按循环 关→4→8→16→32 音测试。
    //     原来 FX_MODE / TEST_MODE 都是编译期 parameter，评委要现场对比
    //     就得重新编译，不合格。现在参数只决定上电默认值。
    //     状态由按键在 pixel 域产生，是秒级变化的电平，跨域用两级同步即可。
    // ------------------------------------------------------------------
    reg [1:0] fx_mode_pix;
    reg [2:0] test_sel_pix;
    always @(posedge pixel_clk or negedge pixel_reset_n) begin
        if(!pixel_reset_n) begin
            fx_mode_pix<=FX_MODE[1:0];
            test_sel_pix<=!TEST_MODE ? 3'd0 :
                         (TEST_COUNT<=4) ? 3'd1 :
                         (TEST_COUNT<=8) ? 3'd2 :
                         (TEST_COUNT<=16) ? 3'd3 : 3'd4;
        end else begin
            if(fx_step)   fx_mode_pix<=fx_mode_pix+2'd1;
            if(test_step) test_sel_pix<=(test_sel_pix==3'd4) ? 3'd0 : test_sel_pix+3'd1;
        end
    end
    (* syn_preserve=1 *) reg [1:0] fx_meta, fx_sync;
    (* syn_preserve=1 *) reg [2:0] ts_meta, ts_sync;
    always @(posedge sys_clk or negedge system_reset_n) begin
        if(!system_reset_n) begin
            fx_meta<=2'd0; fx_sync<=2'd0; ts_meta<=3'd0; ts_sync<=3'd0;
        end else begin
            fx_meta<=fx_mode_pix; fx_sync<=fx_meta;
            ts_meta<=test_sel_pix; ts_sync<=ts_meta;
        end
    end
    wire        test_mode_sys = (show_test != 3'd0);
    wire [5:0]  test_count_sys = (show_test==3'd1) ? 6'd4 :
                                 (show_test==3'd2) ? 6'd8 :
                                 (show_test==3'd3) ? 6'd16 : 6'd32;
    // 测试模式必须"不依赖曲子正在播放"也能出声：enabled 原本是 raw_playing，
    // 不OR 上去的话评委一停下曲子，N 音测试就静音了。
    wire        audio_en = enabled | test_mode_sys;

    fsr32_engine #(
        .LAYOUT(1), .VOL_SHIFT(4), .CHROMATIC_AUDITION(1),
        .ROM_FILE(ROM_FILE)
    ) u_pro_engine(
        .clk50(sys_clk), .reset_n(system_reset_n),
        .sample_en(frame_en), .enable(audio_en),
        .note_gate(show_melody ? {15'd0,(auto_note_gate && !(show_stage==25 && bt_active_s))} : live_gate_mix),
        .ext_gate(ext_gate_r), .ext_freq_word(ext_word_r),
        .family(family), .preset(preset), .octave(2'd1),
        .expression(show_expr),            // 兜过下限的力度，不用原始显示值
        .freq_override(show_melody || show_glide || show_stage==13), .freq_override_word(show_melody ? auto_freq_word : show_word),
        .test_mode(test_mode_sys), .test_count(test_count_sys),
        .vib_depth(show_vib),
        .glide_en(show_glide), .glide_rate(3'd3),
        .pcm(pcm32), .voices_active(v32_active),
        .note_on(), .note_off(), .expression_smoothed(), .clipped());

    // 回声延迟线减半（16384->8192，250ms->125ms）：BSRAM 339/340 满载导致
    // 布线失败（PR0004, 167 条网未布通），此举释放 8 块 SDPB 给布线器腾挪。
    // 125 ms 回声在演示中依然清晰可辨；指针/预填充全是 14 bit 参数化，安全。
    fx_rack #(
        .SINE_ROM_FILE(SINE_ROM_FILE),
        .ECHO_DEPTH(8192), .ECHO_DELAY(6000)
    ) u_fx_rack(
        .clk(sys_clk), .reset_n(system_reset_n),
        .sample_en(frame_en), .enable(audio_en),
        .fx_mode(show_fx),
        .pcm_in(pcm32), .pcm_out(pcm_fx), .fx_active(fx_active));

    // ------------------------------------------------------------------
    // 9b. 合成伴奏（低两个八度 bass + 上方五度）—— 直接混进最终输出
    //
    //    【为什么这里必须再挂一份】
    //    score_accompaniment 原本只挂在 fsr16_uart_engine 内部（第 6 节）。
    //    ENGINE_PRO=1 时最终输出走 pcm_fx（32 复音 + 效果器），
    //    fsr16 那条链路的 pcm16 根本没被送出去 ——
    //    于是"伴奏开关"切得动、屏幕字样也会变，但耳朵里永远没有伴奏。
    //    在最终输出端再挂一份，32 复音配置下伴奏才真的能开也能关。
    //
    //    伴奏音源与 16 链路同源：chromatic_audition 解出的曲谱当前音符
    //    （auto_note_gate / auto_freq_word），不是录音轨，是实时合成的。
    // ------------------------------------------------------------------
    wire        acc_on = enabled && show_backing;   // bit29 = backing_enabled
    wire signed [15:0] acc_pcm;
    wire [1:0]  acc_active;
    wire        acc_clipped;
    score_accompaniment u_accomp(
        .clk(sys_clk), .reset_n(system_reset_n),
        .sample_en(frame_en), .enable(acc_on),
        .note_gate(auto_note_gate), .freq_word(auto_freq_word),
        .pcm(acc_pcm), .voices_active(acc_active), .clipped(acc_clipped));

    // ------------------------------------------------------------------
    // 10. 48 kHz 域输出选择 —— 在这里切换，绝不动 I2S 位时钟
    //
    //     伴奏与效果器输出做饱和相加：两个 16 位有符号数之和需 17 位才装得下
    //     （范围 -65536..+65534），相加后钳回 16 位，避免溢出绕回成爆音。
    // ------------------------------------------------------------------
    // 10之三. SD 卡人声（VOCAL.WAV 流式播放）
    //   跑在 sys_clk 域，与音频链路同源，FIFO 因此是单时钟的。
    //   bus_grant 由 pixel_clk 域的 bus_to_wav 同步过来（两个 sys_clk 周期，
    //   仲裁本身是几十毫秒级的事件，两级同步足够）。
    // ------------------------------------------------------------------
    wire        vocal_active, vocal_found, wav_card_ready;
    wire [3:0]  vocal_err, wav_state;
    wire signed [15:0] vocal_pcm;
    (* syn_preserve=1 *) reg [1:0] bus_to_wav_sync;
    always @(posedge sys_clk or negedge system_reset_n) begin
        if (!system_reset_n) bus_to_wav_sync <= 2'b00;
        else                 bus_to_wav_sync <= {bus_to_wav_sync[0], bus_to_wav};
    end
    generate if (ENABLE_VOCAL!=0) begin: GEN_VOCAL
        sd_wav_player #(.SPI_DIV_INIT(280), .SPI_DIV_FAST(8), .DIR_SEC_CAP(8)) u_vocal(
            .clk(sys_clk), .rst_n(system_reset_n),
            .bus_grant(bus_to_wav_sync[1]),
            .enable(enabled && backing_enabled),
            .sample_en(frame_en),
            .pcm_out(vocal_pcm), .active(vocal_active), .file_found(vocal_found),
            .card_ready(wav_card_ready), .err_code(vocal_err), .state_dbg(wav_state),
            .sd_sclk(wv_sclk), .sd_mosi(wv_mosi), .sd_miso(sd_miso), .sd_csn(wv_csn));
    end else begin: GEN_NO_VOCAL
        // 默认比赛配置：没有预录 PCM 播放器，SD 总线始终归 SONG.BIN 装载器。
        assign vocal_pcm=16'sd0;
        assign vocal_active=1'b0;
        assign vocal_found=1'b0;
        assign wav_card_ready=1'b0;
        assign vocal_err=4'd0;
        assign wav_state=4'd0;
        assign wv_sclk=1'b0;
        assign wv_mosi=1'b0;
        assign wv_csn=1'b1;
    end endgenerate

    // ------------------------------------------------------------------
    wire signed [16:0] mix_sum = {pcm_fx[15], pcm_fx} + {acc_pcm[15], acc_pcm};
    wire signed [15:0] mix_pcm = (mix_sum >  32767) ?  16'sd32767 :
                                 (mix_sum < -32768) ? -16'sd32768 : mix_sum[15:0];

    // ---- 主音量：用户音量 + 按同时发声数自动归一化的 headroom ----
    //
    //    【为什么这里必须补一个】
    //    audio_master_volume 原本只挂在 fsr16_audio_wrapper 内部，
    //    ENGINE_PRO=1（推荐配置）时输出根本不经过它，于是：
    //      · S1+S2 组合键调音量在推荐配置下**完全无效**
    //      · 少了 headroom 归一化，单声部实际只有 ±1750 左右（满量程的 ~5%）
    //    这是"接音响声音很小"的第二个原因（第一个是 4c 节的表情增益）。
    //
    //    放在伴奏混音之后，伴奏也一起受主音量控制（与 16 链路口径一致：
    //    那边 backing 同样是在 master volume 之前混进去的）。
    // 人声在最外层混进来：合成声 + 伴奏 已经先做了一次饱和相加（16 bit），
    // 再叠真人声必须再扩一位，否则 VOCAL.WAV 一响就把合成声顶爆成杂音。
    wire signed [16:0] mix_vocal = {mix_pcm[15], mix_pcm} + {vocal_pcm[15], vocal_pcm};
    wire signed [15:0] mix_all   = (mix_vocal >  17'sd32767) ?  16'sd32767 :
                                   (mix_vocal < -17'sd32768) ? -16'sd32768 : mix_vocal[15:0];
    wire signed [15:0] pcm_vol;
    // N 音测试必须按真实 N 计算 headroom；以前只送 v32_active[17:0]，
    // 32 音测试会被误判成 18 音，增益偏大。正常演奏仍沿用原有 18+2+1 口径。
    wire [31:0] master_voices = test_mode_sys ? v32_active :
                                {11'd0, vocal_active, acc_active, v32_active[17:0]};
    audio_master_volume u_master_vol(
        .clk(sys_clk), .reset_n(system_reset_n),
        .sample_en(frame_en), .enable(audio_en),
        .pcm_in(mix_all),
        .voices_active(master_voices),
        .volume_step(vol_step),
        .pcm_out(pcm_vol), .gain_q8(), .volume_smoothed(), .clipped());

    reg signed [15:0] out_pcm;
    always @(posedge sys_clk or negedge system_reset_n) begin
        if (!system_reset_n) out_pcm <= 16'sd0;
        else if (ENGINE_PRO != 0) out_pcm <= pcm_vol;  // 32复音+效果器+伴奏+主音量
        else                      out_pcm <= pcm16;    // 原链路（回退对比）
    end

    i2s_tx u_i2s(
        .clk(sys_clk), .rst_n(system_reset_n),
        .bck(bck), .bck_rise(bck_rise),
        .sample_l(out_pcm), .sample_r(out_pcm),
        .HP_BCK(hp_bck), .HP_WS(hp_ws), .HP_DIN(hp_din),
        .req(), .frame_en(frame_en));

    assign pa_en = system_reset_n;

    // ------------------------------------------------------------------
    // 11. 显示与音游判定
    // ------------------------------------------------------------------
    wire [7:0]  frame_count_ui;
    wire [39:0] inputs_pixel;

    bus_snapshot_cdc #(.WIDTH(40)) u_input_mailbox(
        .src_clk(sys_clk),  .src_reset_n(system_reset_n),
        .src_data({1'b0, (show_stage==25 && bt_active_s ? bt_vel_s : show_expr),
            (show_stage==25 && bt_active_s && bt_note_s>=60 && bt_note_s<=83 ?
             (32'd1 << (bt_note_s-60)) : (show_melody ? {8'd0,controls_system[23:0]} : live_notes))}),
        .dst_clk(pixel_clk), .dst_reset_n(pixel_reset_n), .dst_data(inputs_pixel));
    bus_snapshot_cdc #(.WIDTH(44)) u_control_mailbox(
        .src_clk(pixel_clk), .src_reset_n(pixel_reset_n), .src_data(controls_pixel),
        .dst_clk(sys_clk),  .dst_reset_n(system_reset_n), .dst_data(controls_system));

    // ------------------------------------------------------------------
    // 10之二. 实时波形示波器前端
    //   48 kHz 侧把 PCM 抽稀成 3 kHz 的 8 bit 样本，算出峰值/电平，
    //   打包 25 bit 后走 bus_snapshot_cdc 过到 pixel_clk 域。
    //   只跨 25 bit（不是整块波形缓冲）：波形缓冲放在渲染器自己的
    //   pixel_clk 域里，存储器不改跨时钟，避免队友那版 520 bit 总线
    //   炸出 768 setup / 345 hold 违例的老路。
    // ------------------------------------------------------------------
    wire [7:0]  scope_sample, scope_peak, scope_level;
    wire        scope_valid, scope_toggle;
    audio_wave_scope #(.DECIMATE(16)) u_wave_scope(
        .clk(sys_clk), .reset_n(system_reset_n),
        .sample_en(frame_en), .enable(audio_en),
        .pcm_in(out_pcm),
        .scope_sample(scope_sample), .scope_peak(scope_peak),
        .scope_level(scope_level), .scope_valid(scope_valid),
        .scope_toggle(scope_toggle));
    wire [24:0] wave_mail_pixel;
    bus_snapshot_cdc #(.WIDTH(25)) u_wave_mailbox(
        .src_clk(sys_clk),  .src_reset_n(system_reset_n),
        .src_data({scope_toggle, scope_level, scope_peak, scope_sample}),
        .dst_clk(pixel_clk), .dst_reset_n(pixel_reset_n), .dst_data(wave_mail_pixel));

    // ------------------------------------------------------------------
    // 10之三. 32 频点实时频谱（Goertzel 核，sys_clk 域）
    //   48 kHz 抽取到 6 kHz，4096 点窗，0.683 s 一帧；
    //   结果按频点串行送出 {toggle, bin, level}，窄载荷跨时钟。
    //   存储与显示柱图都在 pixel 域，与波形页完全同构。
    // ------------------------------------------------------------------
    wire [4:0] spec_bin;
    wire [7:0] spec_level;
    wire       spec_toggle;
    audio_spectrum_goertzel u_spectrum(
        .clk(sys_clk), .reset_n(system_reset_n),
        .sample_en(frame_en), .enable(audio_en),
        .pcm_in(out_pcm),
        .spec_bin(spec_bin), .spec_level(spec_level),
        .spec_toggle(spec_toggle), .frame_done());
    wire [13:0] spec_mail_pixel;
    bus_snapshot_cdc #(.WIDTH(14)) u_spec_mailbox(
        .src_clk(sys_clk),  .src_reset_n(system_reset_n),
        .src_data({spec_toggle, spec_bin, spec_level}),
        .dst_clk(pixel_clk), .dst_reset_n(pixel_reset_n), .dst_data(spec_mail_pixel));

    // ------------------------------------------------------------------
    // 10之四. 双通道李萨如图（sys_clk 域打点）
    //   X = 主合成 pcm_fx（32 复音+效果器），Y = 伴奏层 acc_pcm：
    //   两路都是独立相位累加器的真实信号，绝不用单通道延迟伪造圆。
    //   同拍抽稀到 12 kHz 后送 {toggle, quiet, x, y} 跨时钟。
    // ------------------------------------------------------------------
    wire [6:0] liss_x, liss_y;
    wire       liss_quiet, liss_toggle;
    audio_lissajous_scope #(.DECIMATE(4)) u_lissajous(
        .clk(sys_clk), .reset_n(system_reset_n),
        .sample_en(frame_en), .enable(audio_en),
        .pcm_x(pcm_fx), .pcm_y(acc_pcm),
        .liss_x(liss_x), .liss_y(liss_y),
        .liss_quiet(liss_quiet), .liss_toggle(liss_toggle));
    wire [15:0] liss_mail_pixel;
    bus_snapshot_cdc #(.WIDTH(16)) u_liss_mailbox(
        .src_clk(sys_clk),  .src_reset_n(system_reset_n),
        .src_data({liss_toggle, liss_quiet, liss_x, liss_y}),
        .dst_clk(pixel_clk), .dst_reset_n(pixel_reset_n), .dst_data(liss_mail_pixel));

    // 音游 HUD 通路：同样必须先声明再使用，否则整条通路被隐式 1bit wire 悬空
    // 成 0，HUD 会被综合器连根优化掉（曾经的现象：屏幕上看不到任何判定）。
    wire [1:0]  judge_code;
    wire        judge_pulse;
    wire [7:0]  combo, best_combo;
    wire [23:0] game_score;
    wire [15:0] cnt_perfect, cnt_good, cnt_miss;
    wire [7:0]  pf_disp = (cnt_perfect > 16'd255) ? 8'd255 : cnt_perfect[7:0];
    wire [7:0]  gd_disp = (cnt_good    > 16'd255) ? 8'd255 : cnt_good[7:0];
    wire [7:0]  ms_disp = (cnt_miss    > 16'd255) ? 8'd255 : cnt_miss[7:0];
    wire [31:0] game_score_bcd;
    reg  [5:0]  judge_hold;

    wire       game_playing, game_ready, game_advance, game_wrong;
    wire [6:0]  game_note;
    wire [10:0] game_token;
    wire [31:0] game_mask;
    // 音游模式开关：与 rhythm_judge 的 enable 完全同源，保证 HUD 与判定一致
    wire        game_hud_en = game_playing && (practice_mode != 2'd0);

    score_display_core #(.ENABLE_GUIDANCE(1),.SHOWCASE(1)) u_display(
        .showcase_config(show_config_pixel),
        .pixel_clk(pixel_clk), .reset_n(pixel_reset_n),
        .toggle_play(short_play), .next_song(long_song),
        .restart(1'b0), .next_timbre(short_timbre), .toggle_demo(long_mode),
        .next_mode(short_page), .next_instrument(long_family | string_switch),
        .volume_step(volume_step), .volume_edit(volume_edit),
        .practice_mode(2'd0), .backing_enabled(show_config_pixel[3]),
        .external_pressed(inputs_pixel[31:0]),
        .external_expression(inputs_pixel[38:32]),
        .input_online({inputs_pixel[39], 2'b00}),
        // 曲谱在线导入：直接接到蓝牙 / USB-UART 装载器
        .load_we(load_we), .load_addr(load_addr), .load_note(load_note),
        .load_length(load_length), .load_commit(load_commit),
        .load_count(load_count), .load_bpm(load_bpm),
        .lcd_de(lcd_de), .lcd_r(lcd_r), .lcd_g(lcd_g), .lcd_b(lcd_b),
        .frame_count(frame_count_ui), .audio_control(controls_pixel),
        .o_game_playing(game_playing), .o_game_ready(game_ready),
        .o_game_note(game_note), .o_game_token(game_token),
        .o_game_advance(game_advance), .o_game_wrong(game_wrong),
        .o_game_mask(game_mask),
        // 音游 HUD 回灌：把判定结果画回屏幕
        .i_game_enable(game_hud_en),
        .i_game_judge(judge_code), .i_game_judge_hold(judge_hold),
        .i_game_combo(combo), .i_game_best_combo(best_combo),
        .i_game_score_bcd(game_score_bcd),
        .i_game_pf(pf_disp), .i_game_gd(gd_disp), .i_game_ms(ms_disp),
        .wave_mail(wave_mail_pixel),
        .spec_mail(spec_mail_pixel), .liss_mail(liss_mail_pixel),
        .fx_mode(show_config_pixel[8:7]), .test_sel(show_config_pixel[6:4]));

    assign frame_count = frame_count_ui;
    assign lcd_clk     = ~pixel_clk;

    // 音游时基：与 display core 同一 55Hz 帧率（由 frame_count 变化沿生成）
    reg [7:0] prev_frame;
    always @(posedge pixel_clk or negedge pixel_reset_n) begin
        if (!pixel_reset_n) prev_frame <= 8'd0;
        else                prev_frame <= frame_count_ui;
    end
    wire game_tick = (frame_count_ui != prev_frame);

    rhythm_judge u_rhythm(
        .clk(pixel_clk), .reset_n(pixel_reset_n),
        .frame_tick(game_tick),
        .enable(game_playing && (practice_mode != 2'd0)),
        .clear_stats(1'b0),
        .target_ready(game_ready), .target_midi_note(game_note),
        .event_token(game_token),
        .pressed(inputs_pixel[31:0]),
        .target_mask(game_mask),
        .wrong_note(game_wrong), .advance(game_advance),
        .judge_code(judge_code), .judge_pulse(judge_pulse),
        .combo(combo), .best_combo(best_combo), .score(game_score),
        .cnt_perfect(cnt_perfect), .cnt_good(cnt_good), .cnt_miss(cnt_miss));

    // 音游模式开关：与 rhythm_judge 的 enable 完全同源，保证 HUD 与判定一致

    // 判定弹窗可见倒计时（按 55 Hz 帧计）。MISS 停久一点，便于看清错在哪。
    always @(posedge pixel_clk or negedge pixel_reset_n) begin
        if (!pixel_reset_n)                    judge_hold <= 6'd0;
        else if (judge_pulse)                  judge_hold <= (judge_code == 2'd3) ? 6'd30 : 6'd20;
        else if (game_tick && judge_hold != 0) judge_hold <= judge_hold - 1'b1;
    end

    // 得分转 BCD 显示。用移位加三而不是除法器：24 位组合除法在 35 MHz 下
    // 一定超时，这里每拍只做 4 位加三，25 拍出结果，得分变化频率远低于此。
    wire        b2b_done;
    reg         b2b_start;
    reg [23:0]  score_shadow;
    always @(posedge pixel_clk or negedge pixel_reset_n) begin
        if (!pixel_reset_n) begin
            b2b_start    <= 1'b0;
            score_shadow <= 24'd0;
        end else begin
            b2b_start <= 1'b0;
            if (game_score != score_shadow) begin
                score_shadow <= game_score;
                b2b_start    <= 1'b1;
            end
        end
    end
    bin2bcd #(.W(24), .DIGITS(8)) u_b2b(
        .clk(pixel_clk), .reset_n(pixel_reset_n),
        .bin_in(game_score), .start(b2b_start),
        .bcd(game_score_bcd), .done(b2b_done));


    // 音游反馈：判定产生时闪一下 LED（这也给 rhythm_judge 提供了实际负载。
    // 注意：judge/combo/score 若全部悬空，综合器会把整个判定模块 swept 掉，
    // 结果就是"音游功能编译进去了但其实不存在"——这里必须让它有可见出口。）
    reg [4:0] judge_flash;
    always @(posedge pixel_clk or negedge pixel_reset_n) begin
        if (!pixel_reset_n)                        judge_flash <= 5'd0;
        else if (judge_pulse && judge_code == 2'd3) judge_flash <= 5'd31;  // MISS 长闪
        else if (judge_pulse)                       judge_flash <= 5'd15;  // PERFECT/GOOD 短闪
        else if (judge_flash != 5'd0)               judge_flash <= judge_flash - 1'b1;
    end
    wire combo_reward = (combo >= 8'd16);          // 连击 16 以上 LED 常亮

    // LED：led_n[1]=压力板在线（沿用原语义）；
    //      led_n[0]=心跳 + 蓝牙活动 + 触摸载板故障 + 判定闪光 + 连击奖励
    //      （触摸载板故障时心跳被打断，一眼能看出 I2C 掉线，不用接逻辑分析仪）
    wire touch_bad = touch_fault_p | ~touch_online_p;
    assign led_n = {~(frame_count[5] & ~touch_bad | bt_alive | (judge_flash != 5'd0) | combo_reward),
                    ~online};

endmodule
